Devonbolt1/Wall_E_Motherboard/Wall_E_motherboard.kicad_pcb

## KiCad design Wall_E_motherboard.kicad_pcb (2025-05-07)

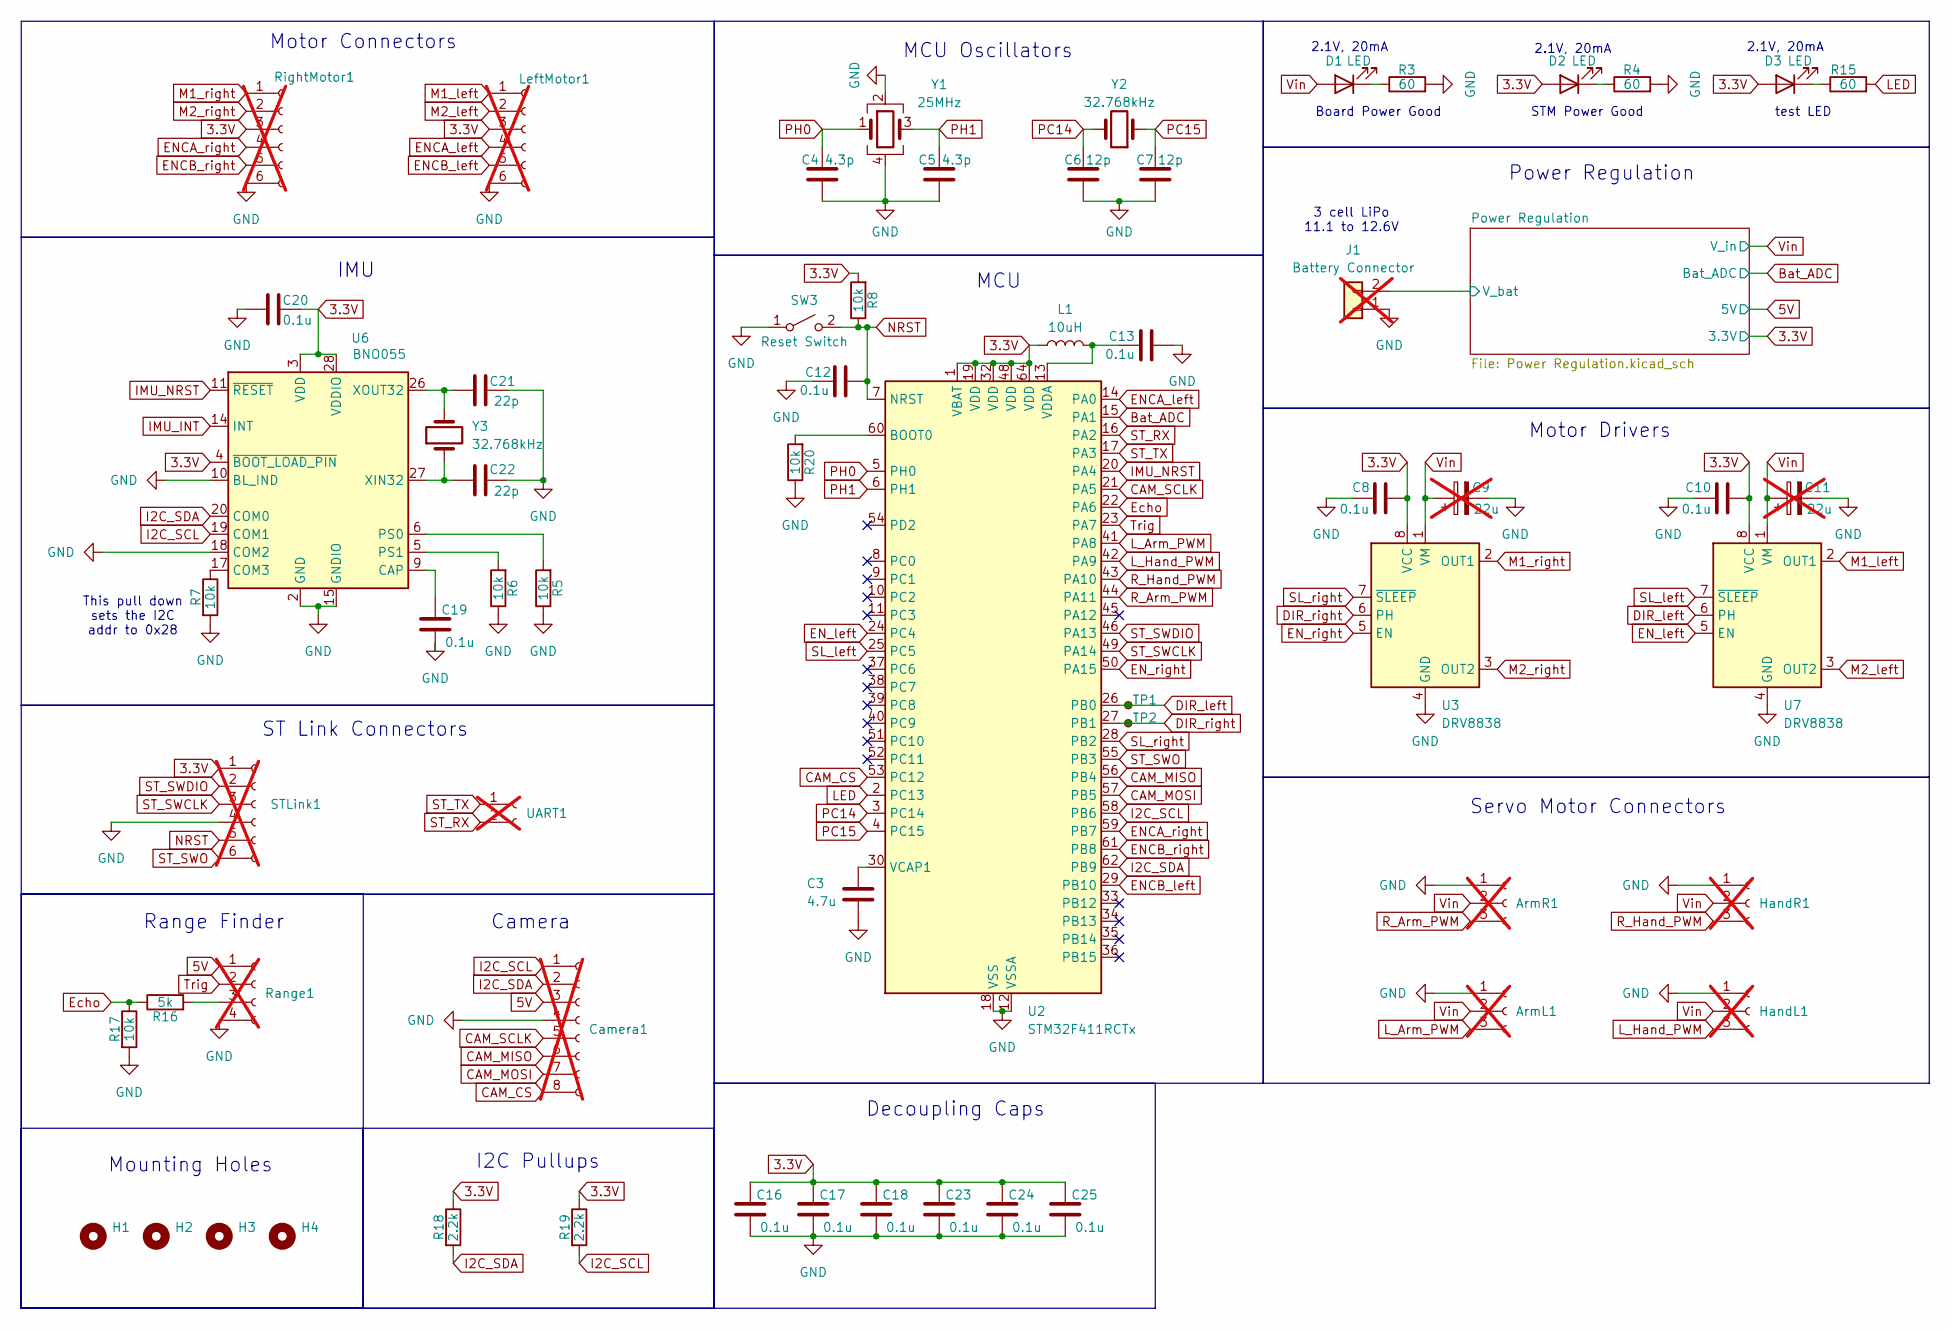
[picture p1: schematic Wall_E_motherboard.kicad_sch, WALL-E Motherboard]

Parts:
ArmL1: Conn_01x03_Socket; PinHeader_1x03_P2.54mm_Vertical; not fitted
ArmR1: Conn_01x03_Socket; PinHeader_1x03_P2.54mm_Vertical; not fitted
C3: 4.7u; C_0603_1608Metric
C4, C5: 4.3p; C_0603_1608Metric
C6, C7: 12p; C_0603_1608Metric
C8, C10, C12, C13, C16, C17, C18, C19, C20, C23, C24, C25: 0.1u; C_0603_1608Metric
C9, C11: 22u; CP_Radial_D5.0mm_P2.00mm; not fitted
C21, C22: 22p; C_0603_1608Metric
Camera1: Conn_01x08_Socket; PinHeader_1x08_P2.54mm_Vertical; not fitted
D1, D2, D3: LED; LED_0603_1608Metric
H1, H2, H3, H4: MountingHole; MountingHole_3.2mm_M3
HandL1: Conn_01x03_Socket; PinHeader_1x03_P2.54mm_Vertical; not fitted
HandR1: Conn_01x03_Socket; PinHeader_1x03_P2.54mm_Vertical; not fitted
J1: Conn_01x02; AMASS_XT30PW-M_1x02_P2.50mm_Horizontal; not fitted
L1: 10uH; L_1008_2520Metric
LeftMotor1: Conn_01x06_Socket; PinHeader_1x06_P2.54mm_Vertical; not fitted
R3, R4, R15: 60; R_0603_1608Metric
R5, R6, R7, R8, R17, R20: 10k; R_0603_1608Metric
R16: 5k; R_0603_1608Metric
R18, R19: 2.2k; R_0603_1608Metric
Range1: Conn_01x04_Socket; PinHeader_1x04_P2.54mm_Vertical; not fitted
RightMotor1: Conn_01x06_Socket; PinHeader_1x06_P2.54mm_Vertical; not fitted
STLink1: Conn_01x06_Socket; PinHeader_1x06_P2.54mm_Horizontal; not fitted
SW3: SW_SPST; SW_SPST_PTS645
TP1, TP2: TestPoint_Small; TestPoint_Pad_D1.0mm
U2: STM32F411RCTx; LQFP-64_10x10mm_P0.5mm
U3, U7: DRV8838; WSON-8-1EP_2x2mm_P0.5mm_EP0.9x1.6mm
U6: BNO055; LGA-28_5.2x3.8mm_P0.5mm
UART1: Conn_01x02_Socket; PinHeader_1x02_P2.54mm_Horizontal; not fitted
Y1: 25MHz; Crystal_SMD_3225-4Pin_3.2x2.5mm
Y2, Y3: 32.768kHz; Crystal_SMD_3215-2Pin_3.2x1.5mm

Connections:
3.3V: C8.1, C10.1, C16.1, C17.1, C18.1, C20.2, C23.1, C24.1, C25.1, D2.2 (A), D3.2 (A), L1.1, LeftMotor1.3, R8.2, R18.1, R19.1, RightMotor1.3, STLink1.1, U2.1 (VBAT), U2.19 (VDD), U2.32 (VDD), U2.48 (VDD), U2.64 (VDD), U3.8 (VCC), U6.3 (VDD), U6.4 (~BOOT_LOAD_PIN), U6.28 (VDDIO), U7.8 (VCC); also elsewhere on the board
5V: Camera1.3, Range1.1; also elsewhere on the board
/Power Regulation/V_bat: J1.2; also elsewhere on the board
Bat_ADC: U2.15 (PA1); also elsewhere on the board
CAM_CS: Camera1.8, U2.53 (PC12)
CAM_MISO: Camera1.6, U2.56 (PB4)
CAM_MOSI: Camera1.7, U2.57 (PB5)
CAM_SCLK: Camera1.5, U2.21 (PA5)
DIR_left: TP1.1, U2.26 (PB0), U7.6 (PH)
DIR_right: TP2.1, U2.27 (PB1), U3.6 (PH)
ENCA_left: LeftMotor1.4, U2.14 (PA0)
ENCA_right: RightMotor1.4, U2.59 (PB7)
ENCB_left: LeftMotor1.5, U2.29 (PB10)
ENCB_right: RightMotor1.5, U2.61 (PB8)
EN_left: U2.24 (PC4), U7.5 (EN)
EN_right: U2.50 (PA15), U3.5 (EN)
Echo: R16.1, R17.1, U2.22 (PA6)
GND: ArmL1.1, ArmR1.1, C3.2, C4.2, C5.2, C6.2, C7.2, C8.2, C9.2, C10.2, C11.2, C12.2, C13.2, C16.2, C17.2, C18.2, C19.2, C20.1, C21.2, C22.2, C23.2, C24.2, C25.2, Camera1.4, HandL1.1, HandR1.1, J1.1, LeftMotor1.6, R3.2, R4.2, R5.1, R6.1, R7.2, R17.2, R20.1, Range1.4, RightMotor1.6, STLink1.4, SW3.1 (A), U2.12 (VSSA), U2.18 (VSS), U2.31 (VSS), U2.47 (VSS), U2.63 (VSS), U3.4 (GND), U3.9 (GND), U6.2 (GND), U6.10 (BL_IND), U6.15 (GNDIO), U6.16 (GNDIO), U6.18 (COM2), U6.25 (GNDIO), U7.4 (GND), U7.9 (GND), Y1.2, Y1.4; also elsewhere on the board
I2C_SCL: Camera1.1, R19.2, U2.58 (PB6), U6.19 (COM1)
I2C_SDA: Camera1.2, R18.2, U2.62 (PB9), U6.20 (COM0)
IMU_INT: U6.14 (INT)
IMU_NRST: U2.20 (PA4), U6.11 (~RESET)
LED: R15.2, U2.2 (PC13)
L_Arm_PWM: ArmL1.3, U2.41 (PA8)
L_Hand_PWM: HandL1.3, U2.42 (PA9)
M1_left: LeftMotor1.1, U7.2 (OUT1)
M1_right: RightMotor1.1, U3.2 (OUT1)
M2_left: LeftMotor1.2, U7.3 (OUT2)
M2_right: RightMotor1.2, U3.3 (OUT2)
NRST: C12.1, R8.1, STLink1.5, SW3.2 (B), U2.7 (NRST)
unnamed: D1.1 (K), R3.1
unnamed: D2.1 (K), R4.1
unnamed: D3.1 (K), R15.1
unnamed: R16.2, Range1.3
unnamed: R20.2, U2.60 (BOOT0)
unnamed: C3.1, U2.30 (VCAP1)
unnamed: C13.1, L1.2, U2.13 (VDDA)
unnamed: C19.1, U6.9 (CAP)
unnamed: R7.1, U6.17 (COM3)
unnamed: R5.2, U6.6 (PS0)
unnamed: R6.2, U6.5 (PS1)
unnamed: C22.1, U6.27 (XIN32), Y3.1
unnamed: C21.1, U6.26 (XOUT32), Y3.2
PC14: C6.1, U2.3 (PC14), Y2.2
PC15: C7.1, U2.4 (PC15), Y2.1
PH0: C4.1, U2.5 (PH0), Y1.1
PH1: C5.1, U2.6 (PH1), Y1.3
R_Arm_PWM: ArmR1.3, U2.44 (PA11)
R_Hand_PWM: HandR1.3, U2.43 (PA10)
SL_left: U2.25 (PC5), U7.7 (~SLEEP)
SL_right: U2.28 (PB2), U3.7 (~SLEEP)
ST_RX: U2.16 (PA2), UART1.2
ST_SWCLK: STLink1.3, U2.49 (PA14)
ST_SWDIO: STLink1.2, U2.46 (PA13)
ST_SWO: STLink1.6, U2.55 (PB3)
ST_TX: U2.17 (PA3), UART1.1
Trig: Range1.2, U2.23 (PA7)
Vin: ArmL1.2, ArmR1.2, C9.1, C11.1, D1.2 (A), HandL1.2, HandR1.2, U3.1 (VM), U7.1 (VM); also elsewhere on the board

Notes on the sheet:
Decoupling Caps
STM Power Good
Board Power Good
Range Finder
Power Regulation
Mounting Holes
Camera
MCU Oscillators
Motor Connectors
Servo Motor Connectors
ST Link Connectors
2.1V, 20mA
IMU
Motor Drivers
I2C Pullups
3 cell LiPo 11.1 to 12.6V
test LED
This pull down sets the I2C addr to 0x28
MCU

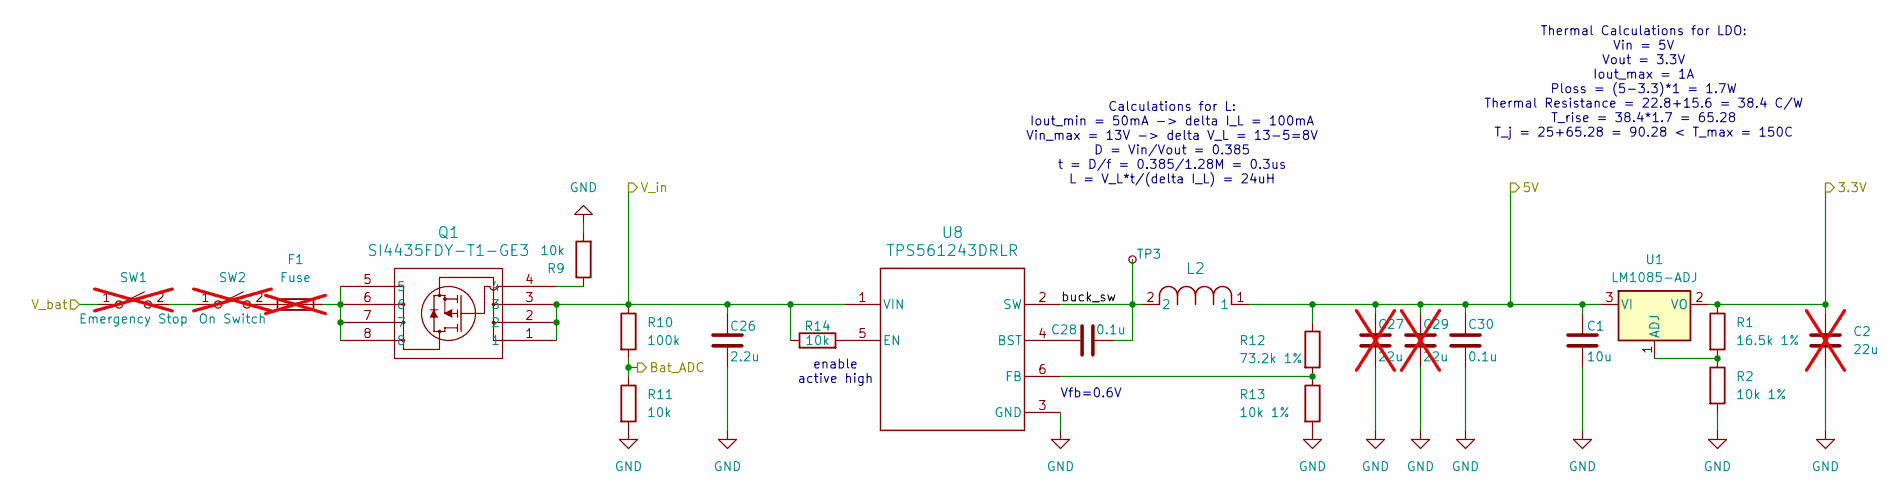
[picture p2: schematic Power Regulation.kicad_sch, Wall-E Power Regulation]

Parts:
C1: 10u; C_0603_1608Metric
C2, C27, C29: 22u; CP_Radial_D5.0mm_P2.00mm; not fitted
C26: 2.2u; C_0603_1608Metric
C28, C30: 0.1u; C_0603_1608Metric
F1: Fuse; Fuseholder_Blade_Mini_Keystone_3568; not fitted
L2: IFDC5050HZER270M; IND_IFDC5050HZER_VIS
Q1: SI4435FDY-T1-GE3; SO-8_VIS
R1: 16.5k 1%; R_0603_1608Metric
R2, R13: 10k 1%; R_0603_1608Metric
R9, R11, R14: 10k; R_0603_1608Metric
R10: 100k; R_0603_1608Metric
R12: 73.2k 1%; R_0603_1608Metric
SW1, SW2: SW_SPST; AMASS_XT30PW-F_1x02_P2.50mm_Horizontal; not fitted
TP3: TestPoint_Small; TestPoint_Pad_D1.0mm
U1: LM1085-ADJ; TO-263-3_TabPin2
U8: TPS561243DRLR; DRL0006A-MFG

Connections:
3.3V: C2.1, R1.1, U1.2 (VO); also elsewhere on the board
5V: C1.1, C27.1, C29.1, C30.1, L2.1, R12.1, U1.3 (VI); also elsewhere on the board
/Power Regulation/V_bat: SW1.1 (A); also elsewhere on the board
/Power Regulation/buck_sw: C28.2, L2.2, TP3.1, U8.2 (SW)
Bat_ADC: R10.2, R11.1; also elsewhere on the board
GND: C1.2, C2.2, C26.2, C27.2, C29.2, C30.2, R2.2, R9.2, R11.2, R13.2, U8.3 (GND); also elsewhere on the board
unnamed: F1.2, Q1.5, Q1.6, Q1.7, Q1.8
unnamed: Q1.4, R9.1
unnamed: SW1.2 (B), SW2.1 (A)
unnamed: F1.1, SW2.2 (B)
unnamed: R1.2, R2.1, U1.1 (ADJ)
unnamed: C28.1, U8.4 (BST)
unnamed: R14.2, U8.5 (EN)
unnamed: R12.2, R13.1, U8.6 (FB)
Vin: C26.1, Q1.1, Q1.2, Q1.3, R10.1, R14.1, U8.1 (VIN); also elsewhere on the board

Notes on the sheet:
Vfb=0.6V
Calculations for L: Iout_min = 50mA -> delta I_L = 100mA Vin_max = 13V -> delta V_L = 13-5=8V D = Vin/Vout = 0.385 t = D/f = 0.385/1.28M = 0.3us L = V_L*t/(delta I_L) = 24uH
enable active high
Thermal Calculations for LDO: Vin = 5V Vout = 3.3V Iout_max = 1A Ploss = (5-3.3)*1 = 1.7W Thermal Resistance = 22.8+15.6 = 38.4 C/W T_rise = 38.4*1.7 = 65.28 T_j = 25+65.28 = 90.28 < T_max = 150C

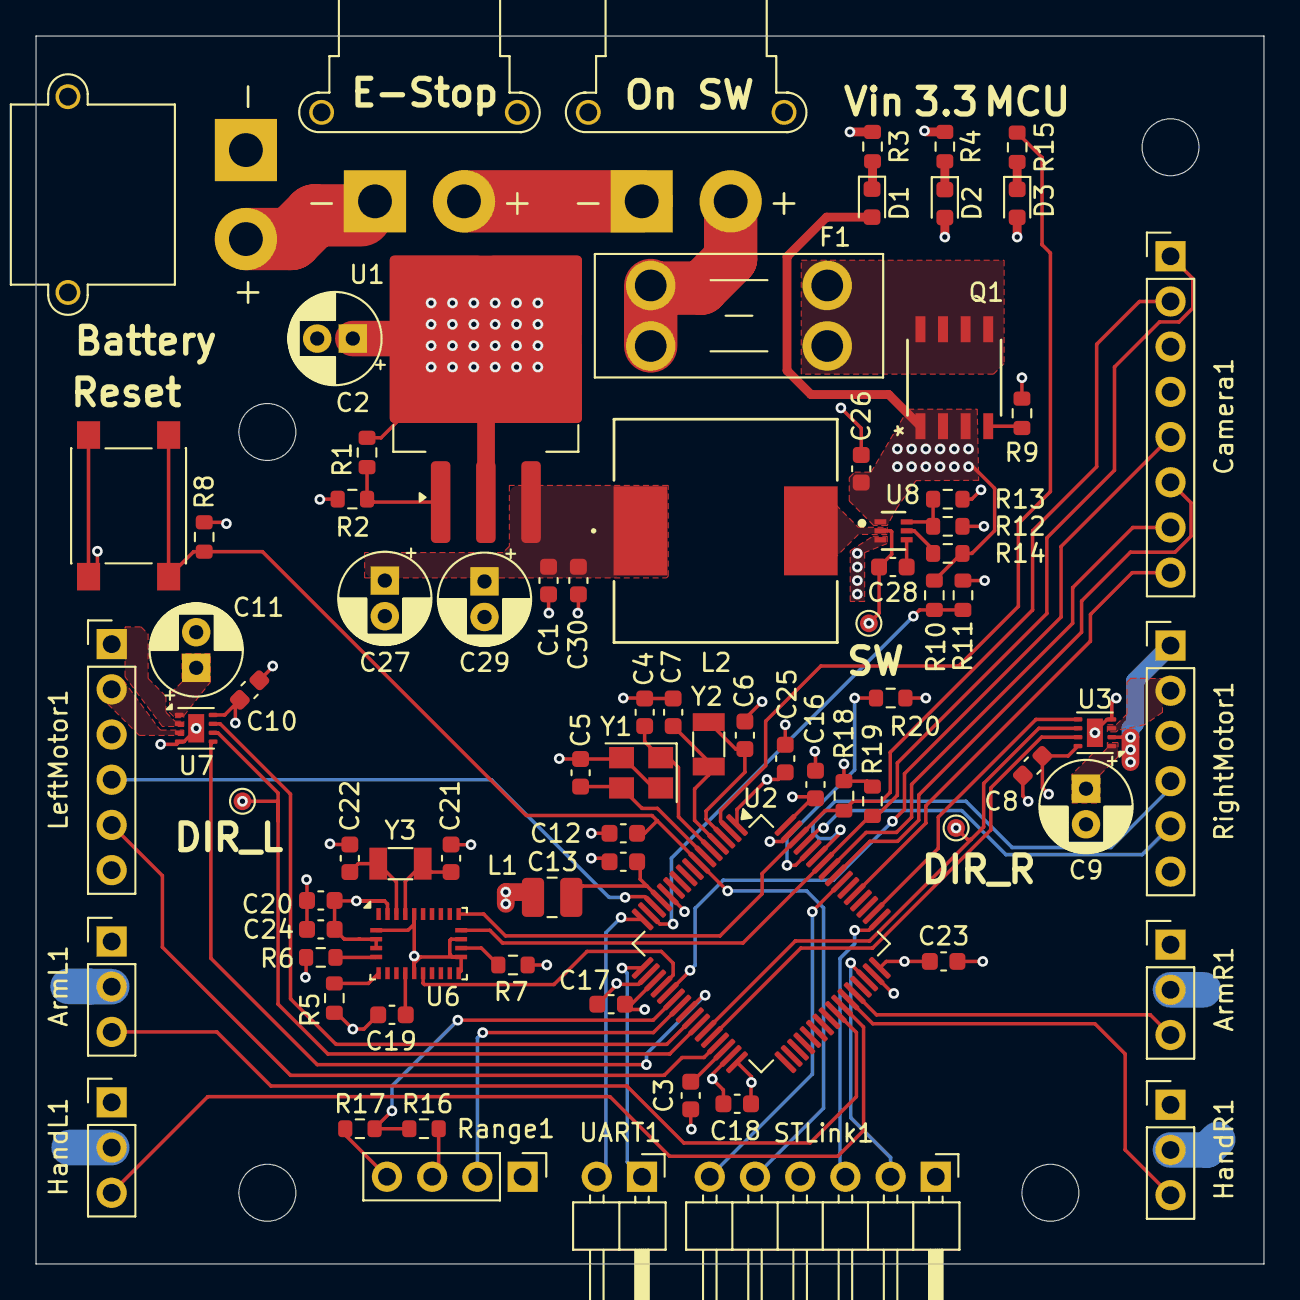
[picture p3: board Wall_E_motherboard.kicad_pcb from above]

Board: 4 copper layers, 69.0 x 69.0 mm, 85 parts (0 on the bottom side), 66 nets.
