Devonbolt1/Wall_E_Motherboard/(commit log)

2025-04-20 Added initial files
    [Power Regulation.kicad_sch, Wall_E_motherboard.kicad_pcb, Wall_E_motherboard.kicad_sch]
2025-04-20 Added some footprints and made some connections
    [Power Regulation.kicad_sch, Wall_E_motherboard.kicad_sch]
2025-04-21 initial routing of power and MCU sections
    [Power Regulation.kicad_sch, Wall_E_motherboard.kicad_pcb, Wall_E_motherboard.kicad_sch]
2025-05-01 Routing Updates
    [Power Regulation.kicad_sch, Wall_E_motherboard.kicad_pcb, Wall_E_motherboard.kicad_sch]
2025-05-02 continued routing
    [Power Regulation.kicad_sch, Wall_E_motherboard.kicad_pcb, Wall_E_motherboard.kicad_sch]
2025-05-03 Routing first draft complete
    [Wall_E_motherboard.kicad_pcb, Wall_E_motherboard.kicad_sch]
2025-05-03 Final commit before Charlie review
    [Power Regulation.kicad_sch, Wall_E_motherboard.kicad_pcb, Wall_E_motherboard.kicad_sch]
2025-05-05 added resistor divider to Echo pin
    [Wall_E_motherboard.kicad_pcb, Wall_E_motherboard.kicad_sch]
2025-05-07 Final design before order
    [Power Regulation.kicad_sch, Wall_E_motherboard.kicad_pcb, Wall_E_motherboard.kicad_sch]
